polihedron/PowerLED-timer/schematicsX12.pdf

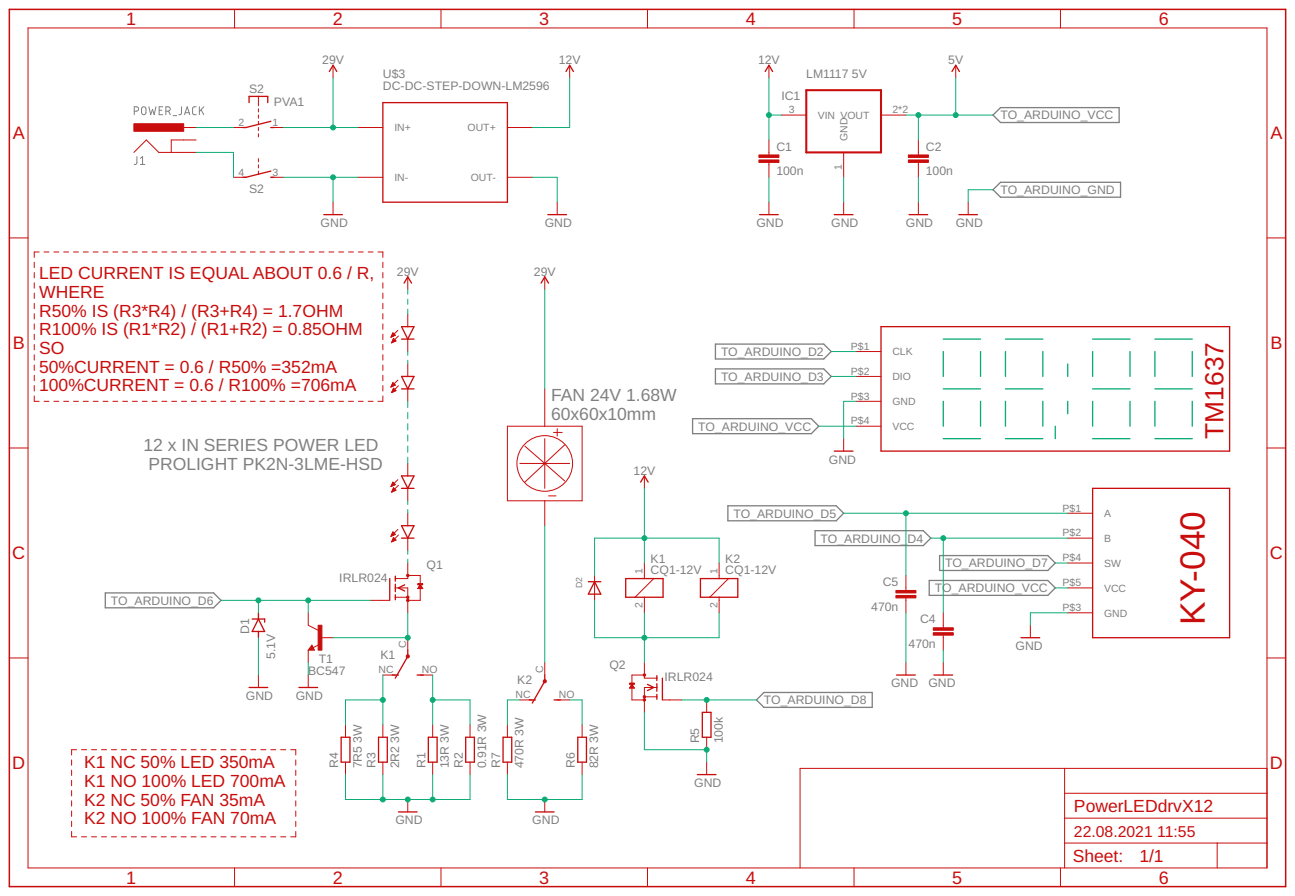
[picture p3: page 1]

DC-DC-STEP-DOWN-LM2596

LED CURRENT IS EQUAL ABOUT 0.6 / R, WHERE

12 x IN SERIES POWER LED
PROLIGHT PK2N-3LME-HSD
