polihedron/PowerLED-timer/schematicsX18.pdf

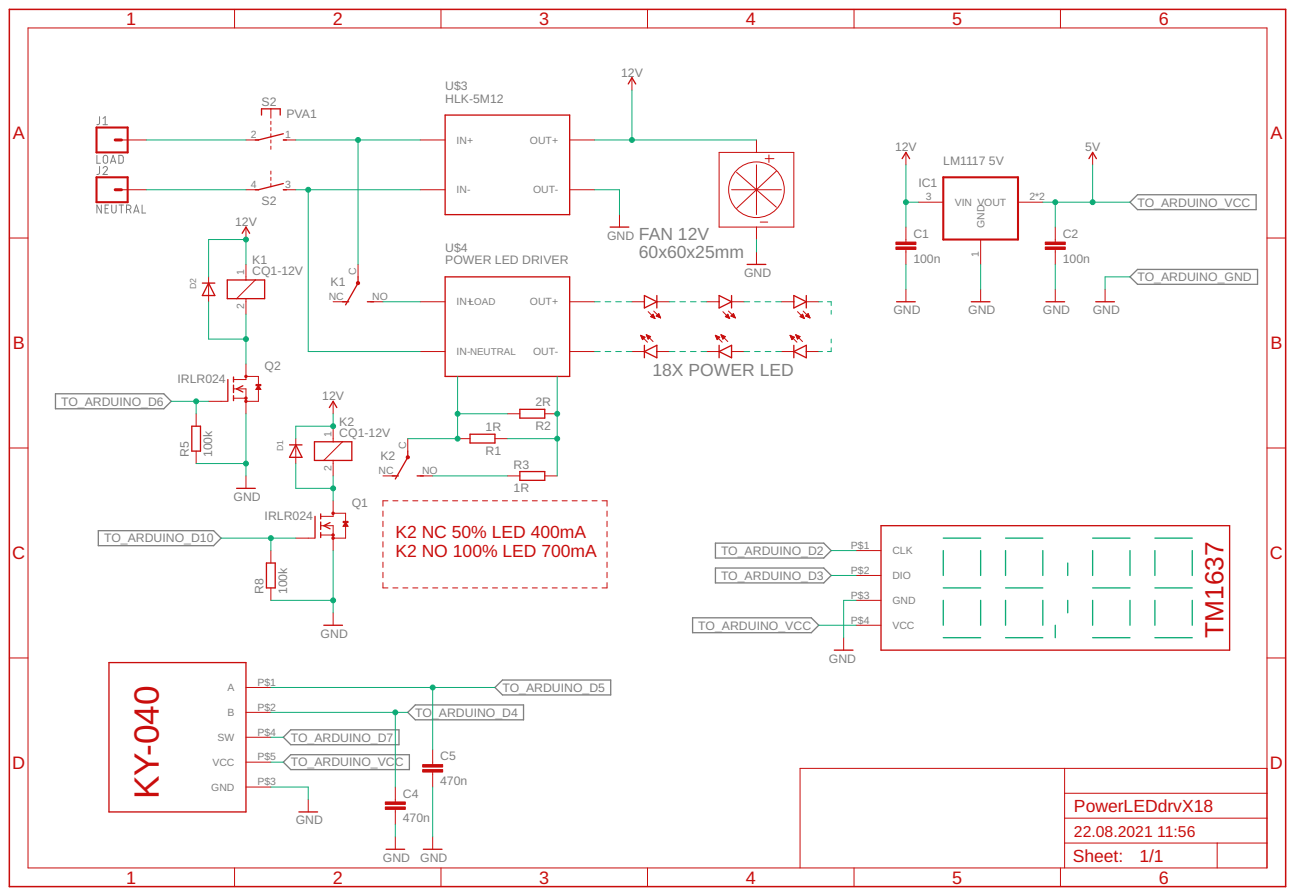
[picture p4: page 1]
