polihedron/PowerLED-timer/(commit log)

2021-08-15 main switch
2021-08-22 simple filter for encoder
